coxfuture/One-Handed-Keyboard/Model/readme.md

## Heat-set insert and fastener installation guide

#### Large keyboard

> The left-hand large keyboard is used as the example here.

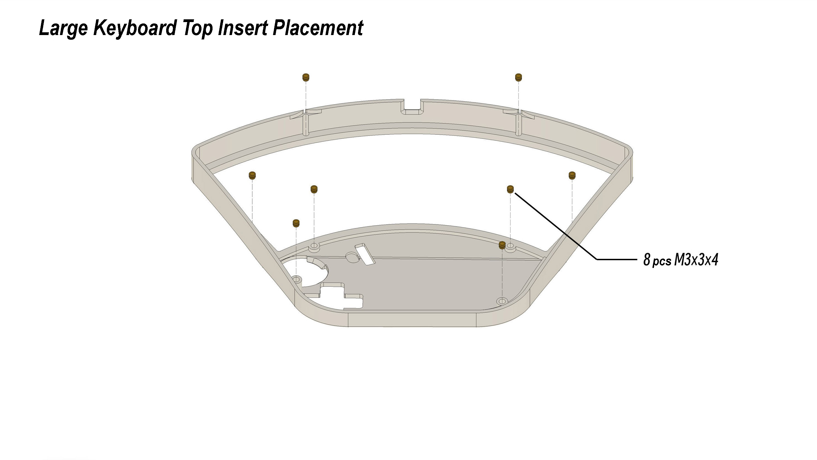
[picture p5: Docs/Image/left-large-keyboard-top-case-insert-guide.jpg]
Left-hand large keyboard: heat-set insert installation in the top case


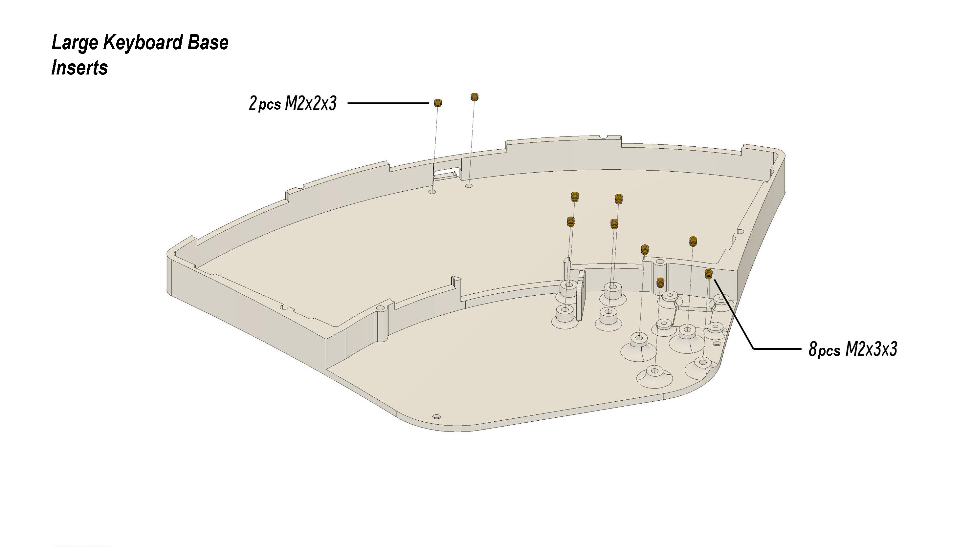
[picture p6: Docs/Image/left-large-keyboard-base-insert-guide.jpg]
Left-hand large keyboard: heat-set insert installation in the base


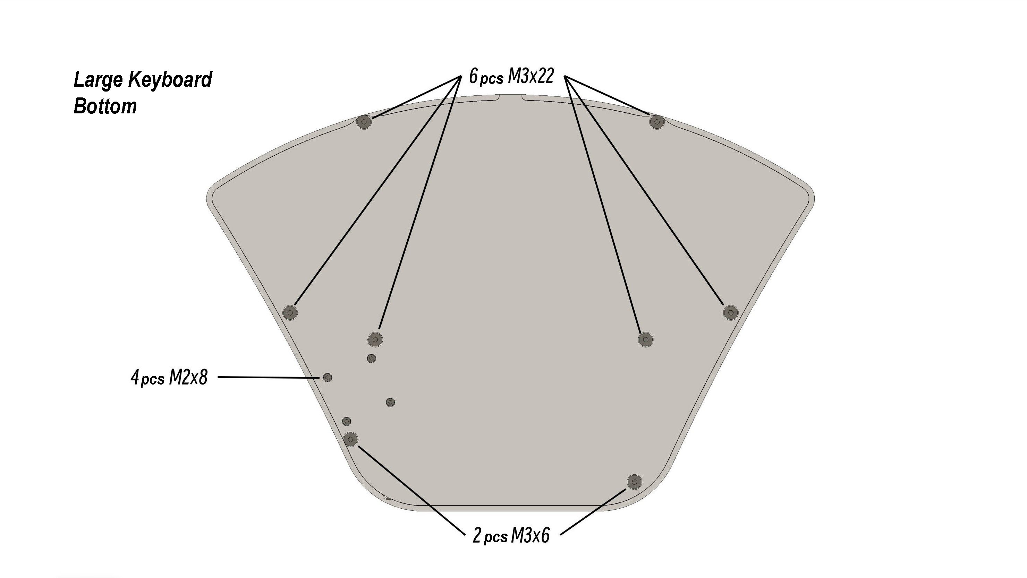
[picture p7: Docs/Image/left-large-keyboard-bottom-screw-guide.jpg]
Left-hand large keyboard: bottom screw installation


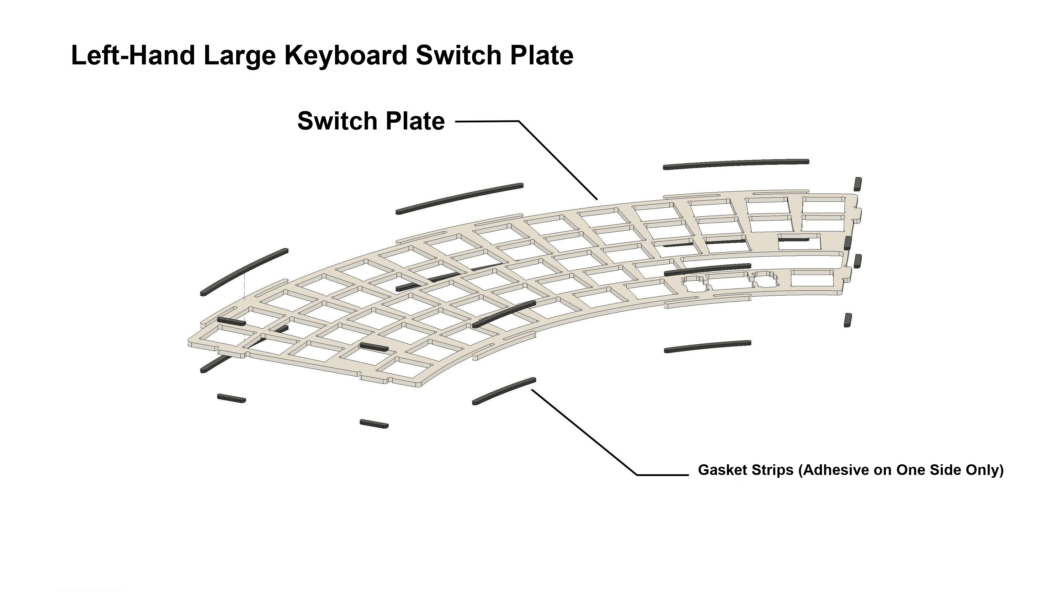
[picture p8: Docs/Image/left-large-keyboard-gasket-strip-guide.jpg]
Left-hand large keyboard: gasket strip installation


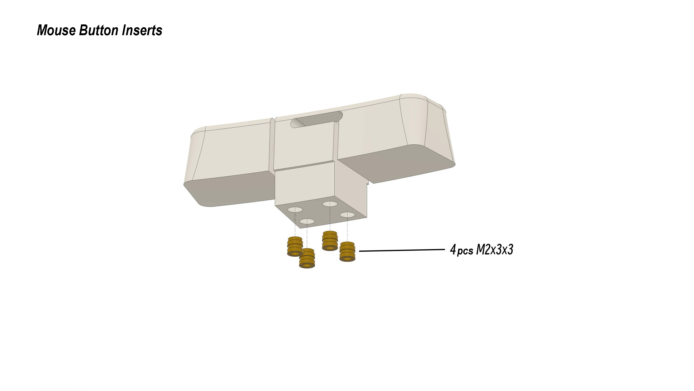
[picture p9: Docs/Image/large-keyboard-mouse-button-insert-guide.jpg]
Large keyboard: heat-set insert installation for the mouse buttons


#### Small keyboard

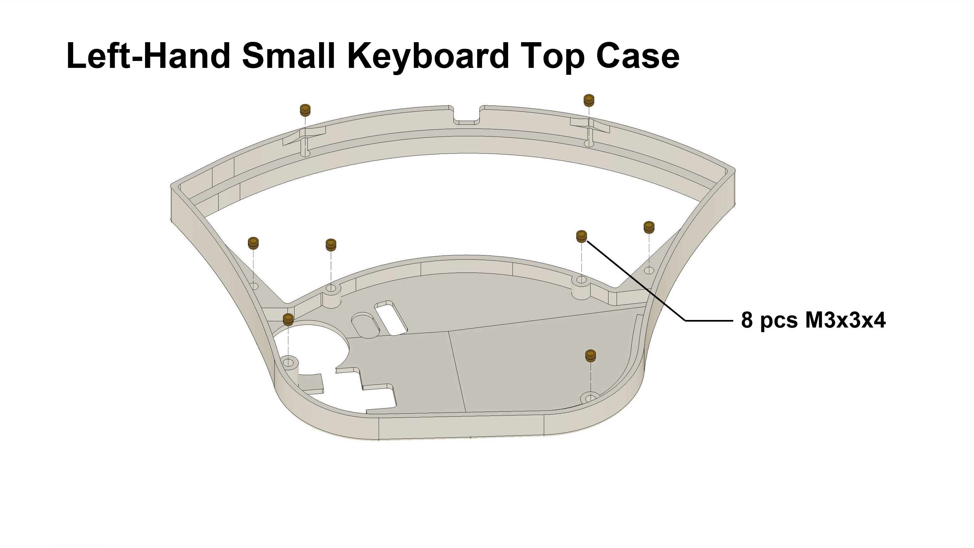
[picture p10: Docs/Image/left-small-keyboard-top-case-insert-guide.jpg]
Left-hand small keyboard: heat-set insert installation in the top case


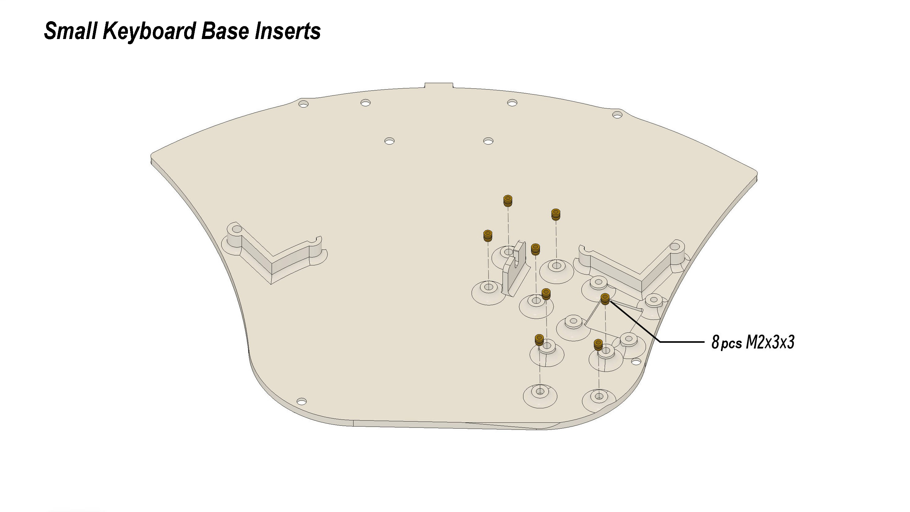
[picture p11: Docs/Image/left-small-keyboard-base-insert-guide.jpg]
Left-hand small keyboard: heat-set insert installation in the base


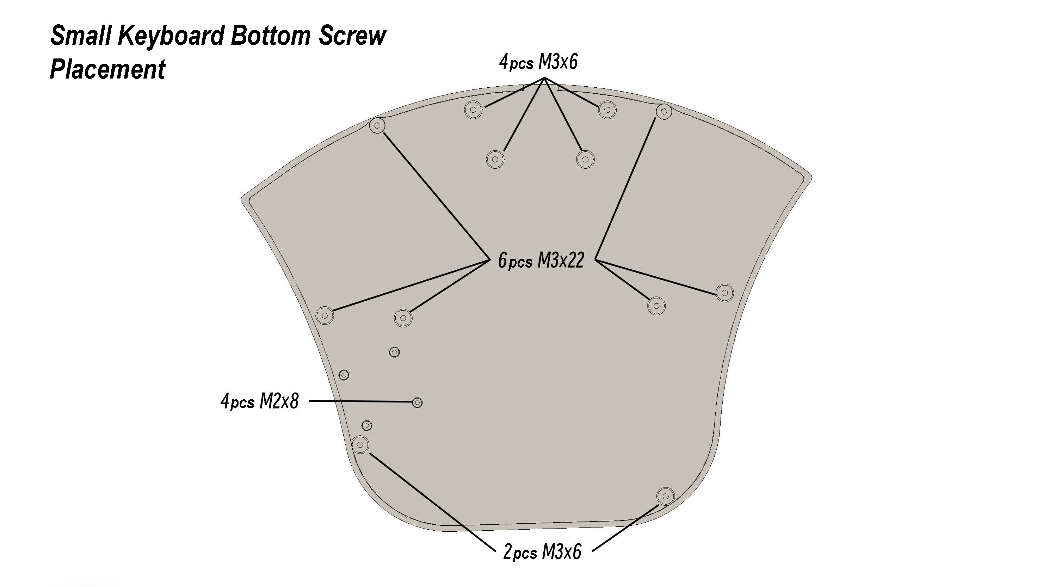
[picture p12: Docs/Image/left-small-keyboard-bottom-screw-guide.jpg]
Left-hand small keyboard: bottom screw installation


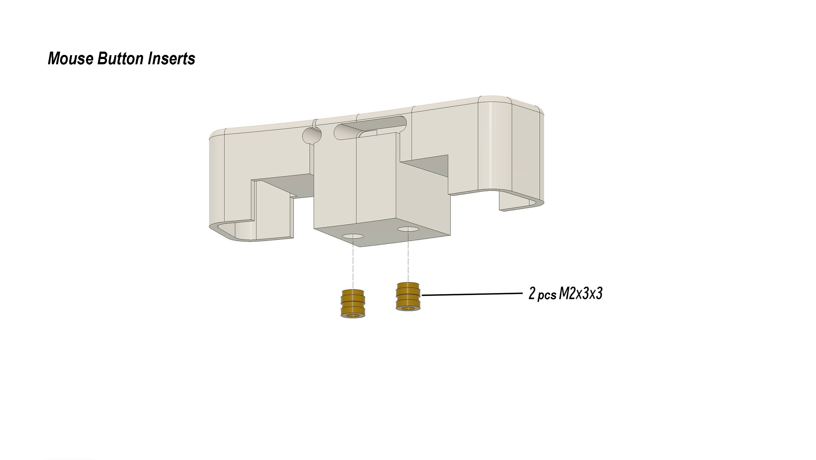
[picture p13: Docs/Image/small-keyboard-mouse-button-insert-guide.jpg]
Small keyboard: heat-set insert installation for the mouse buttons


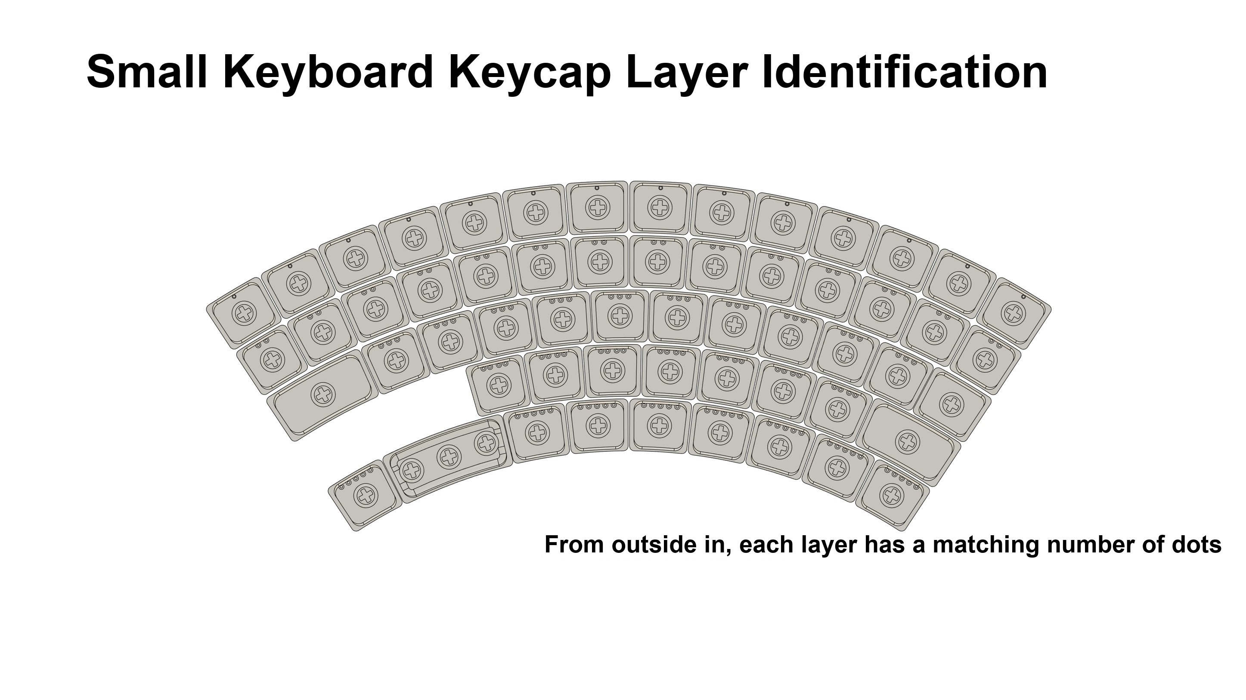
[picture p14: Docs/Image/small-keyboard-keycap-layer-identification.jpg]
Small keyboard: identifying the keycap layers


> The large keyboard's keycaps are identified the same way.

#### Other

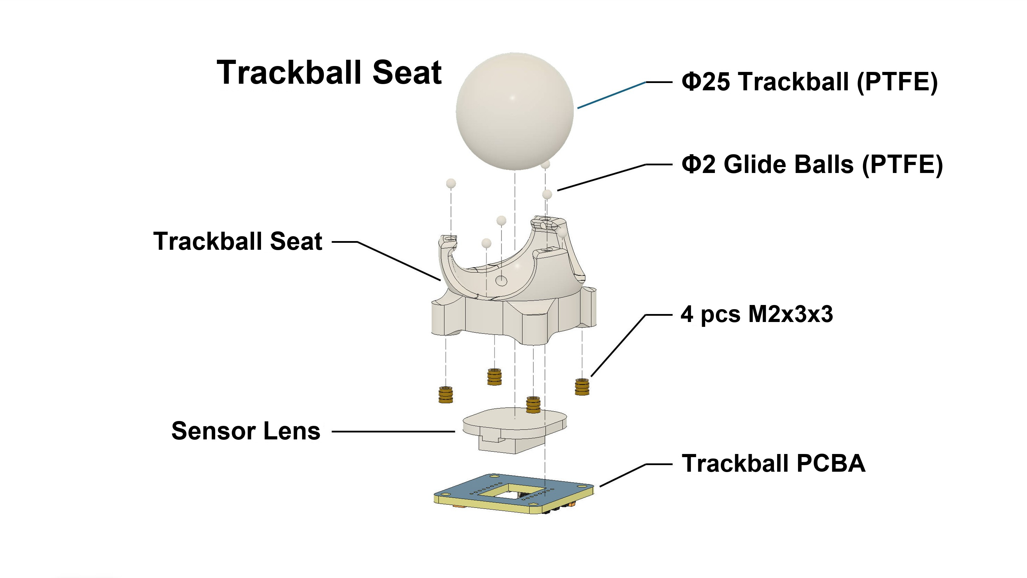
[picture p15: Docs/Image/trackball-installation-guide.jpg]
Trackball installation guide
