coxfuture/One-Handed-Keyboard/Firmware/One-Handed_Keyboard_ML/readme.md

# One-Handed_Keyboard_ML

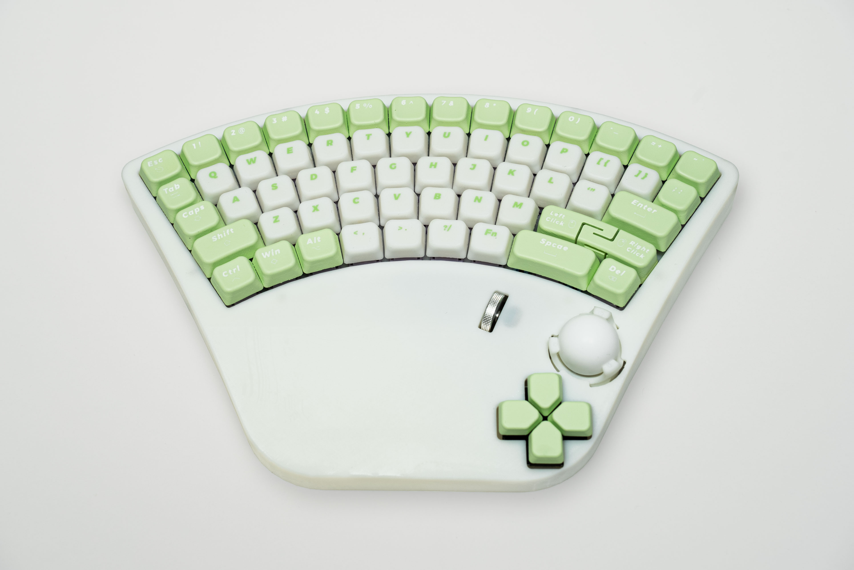
[picture p16: Docs/Image/left-large-keyboard-front.jpg]
Left-hand large keyboard, front


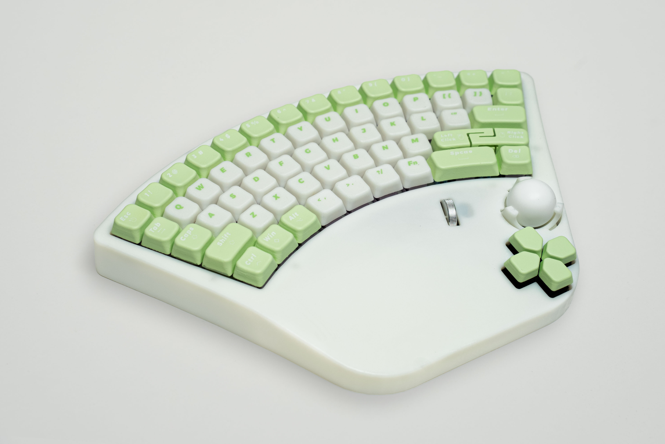
[picture p17: Docs/Image/left-large-keyboard-left-side.jpg]
Left-hand large keyboard, side


---

Powered by [QMK](https://docs.qmk.fm/)
