coxfuture/One-Handed-Keyboard/Firmware/One-Handed_Keyboard_MR/readme.md

# One-Handed_Keyboard_MR

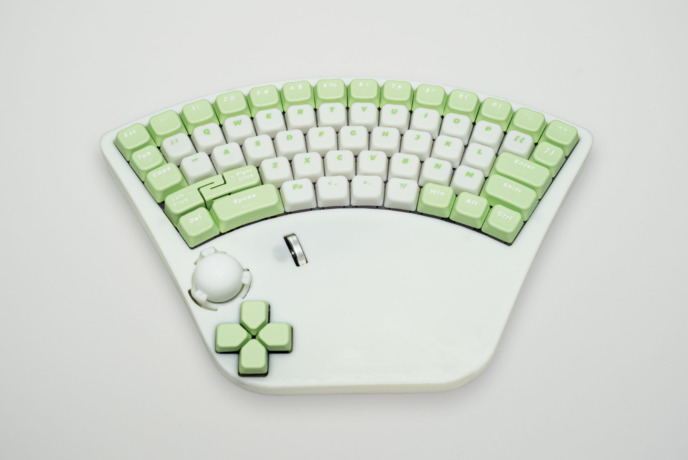
[picture p18: Docs/Image/right-large-keyboard-front.jpg]
Right-hand large keyboard, front


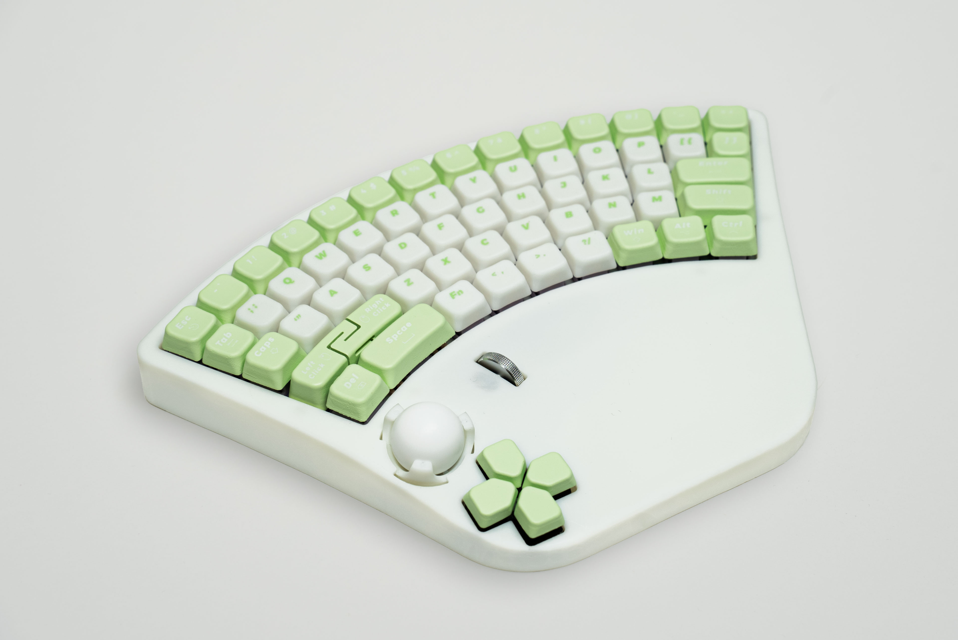
[picture p19: Docs/Image/right-large-keyboard-left-side.jpg]
Right-hand large keyboard, side


---

Powered by [QMK](https://docs.qmk.fm/)
