coxfuture/One-Handed-Keyboard/Firmware/One-Handed_Keyboard_SL/readme.md

# One-Handed_Keyboard_SL

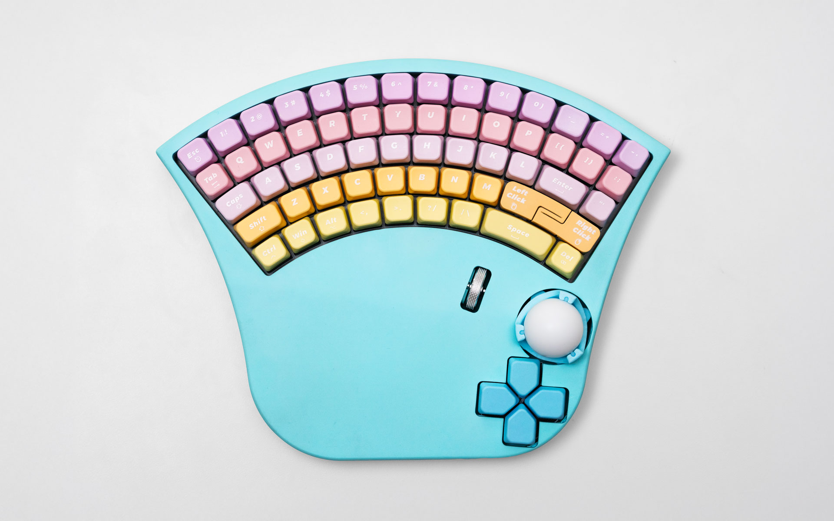
[picture p20: Docs/Image/left-small-keyboard-front.jpg]
Left-hand small keyboard, front


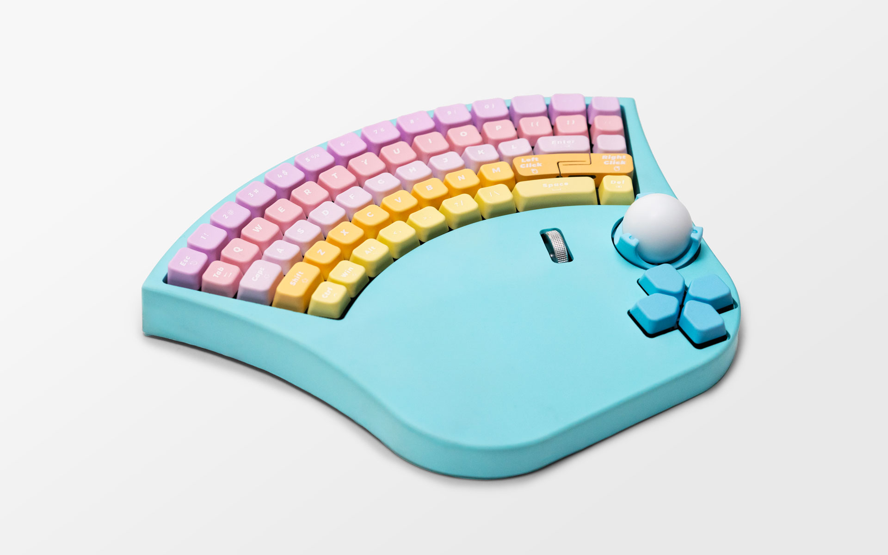
[picture p21: Docs/Image/left-small-keyboard-left-side.jpg]
Left-hand small keyboard, side


---

Powered by [QMK](https://docs.qmk.fm/)
