coxfuture/One-Handed-Keyboard/Docs/Image/right-large-keyboard-right-side.jpg

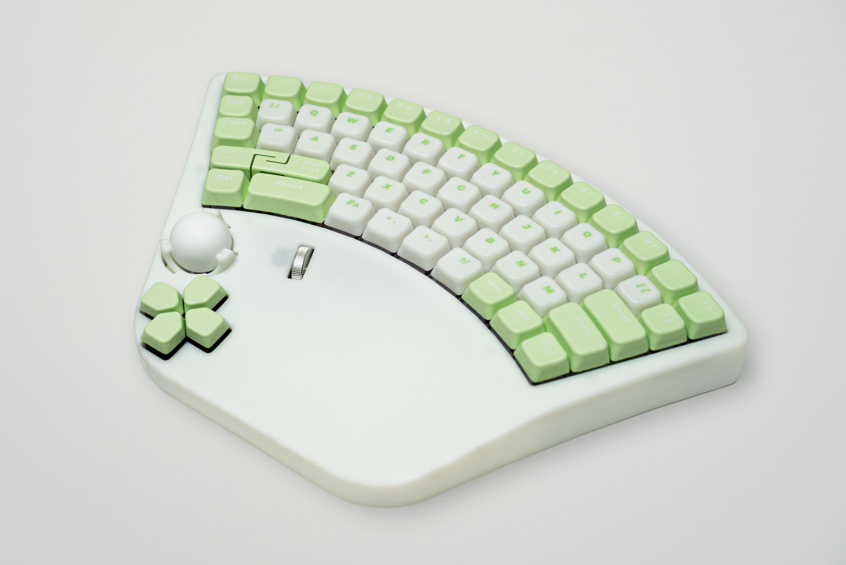
Docs/Image/right-large-keyboard-right-side.jpg
