coxfuture/One-Handed-Keyboard/Model/One-Handed_Keyboard_ML/top-case_left.STL

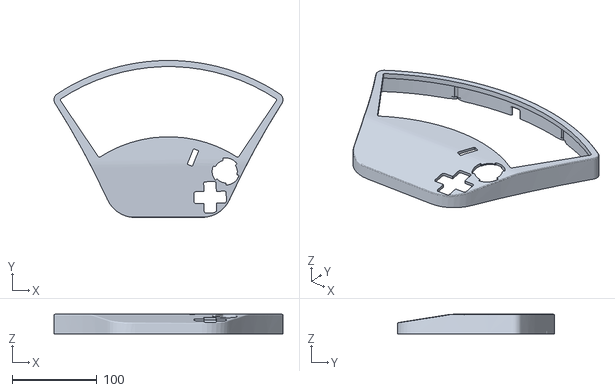
[picture p23: CAD file, 2026-11-01]
Model/One-Handed_Keyboard_ML/top-case_left.STL
269.8 x 185.0 x 23.0
