coxfuture/One-Handed-Keyboard/Model/One-Handed_Keyboard_MR/arrow-key-keycaps.STL

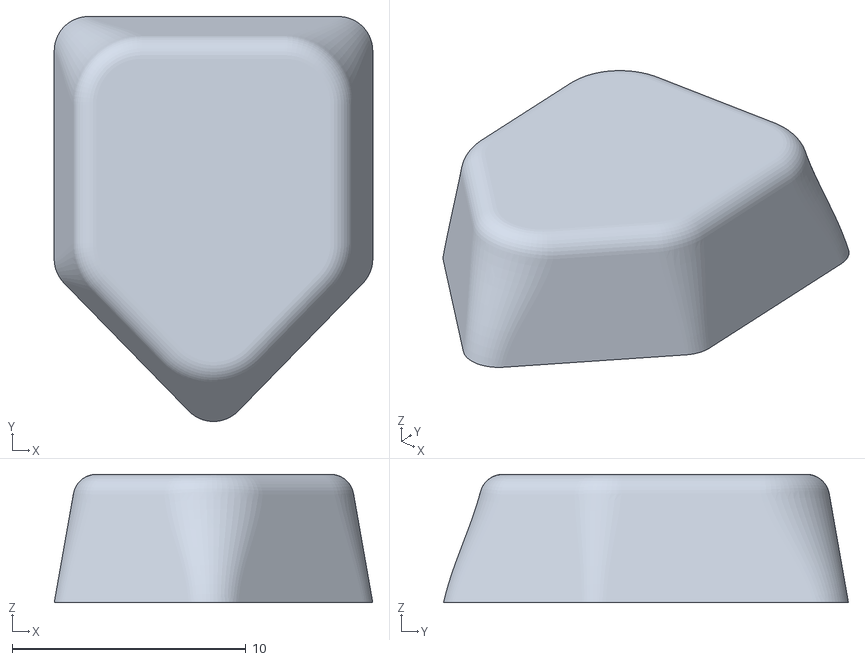
[picture p24: CAD file, 2026-11-01]
Model/One-Handed_Keyboard_MR/arrow-key-keycaps.STL
13.6 x 17.3 x 5.50
