coxfuture/One-Handed-Keyboard/Model/One-Handed_Keyboard_SL/trackball-seat.STL

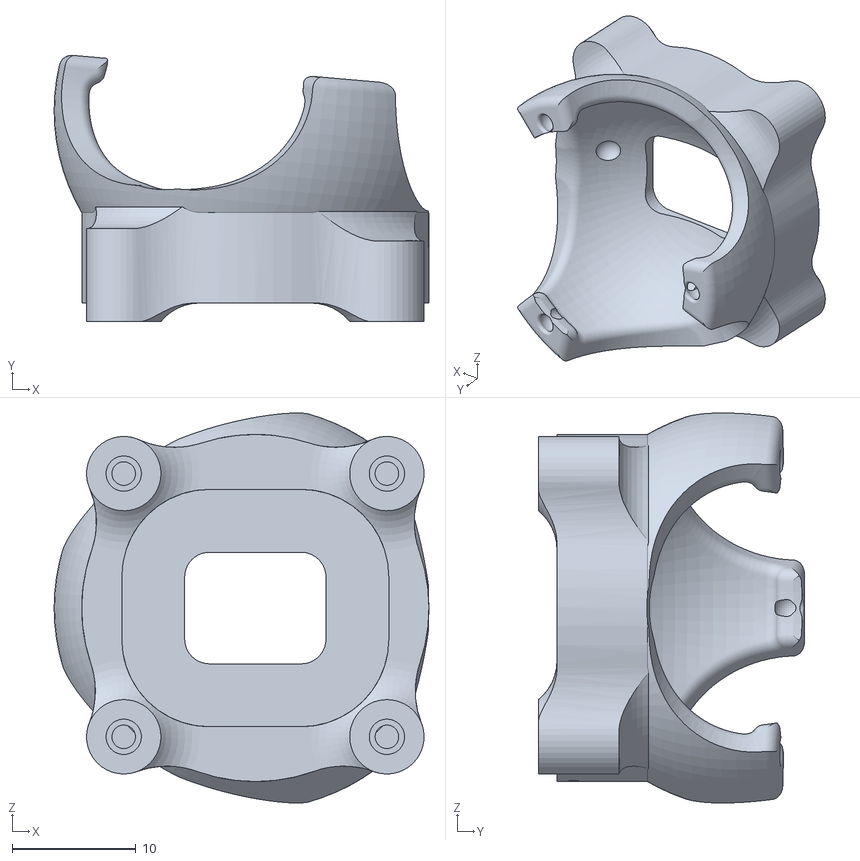
[picture p25: CAD file, 2026-11-01]
Model/One-Handed_Keyboard_SL/trackball-seat.STL
30.2 x 21.5 x 31.5
