coxfuture/One-Handed-Keyboard/Model/One-Handed_Keyboard_ML/plate-gasket-strips-top-bottom.DXF

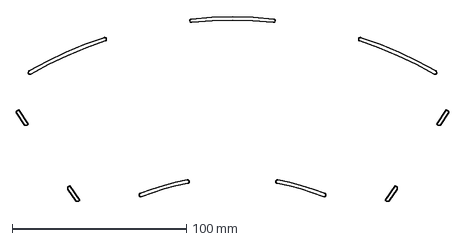
[picture p26: CAD file, 2026-11-01]
Model/One-Handed_Keyboard_ML/plate-gasket-strips-top-bottom.DXF
248.6 x 106.5 mm
