coxfuture/One-Handed-Keyboard/Model/One-Handed_Keyboard_MR/switch-seat-foam_right.DXF

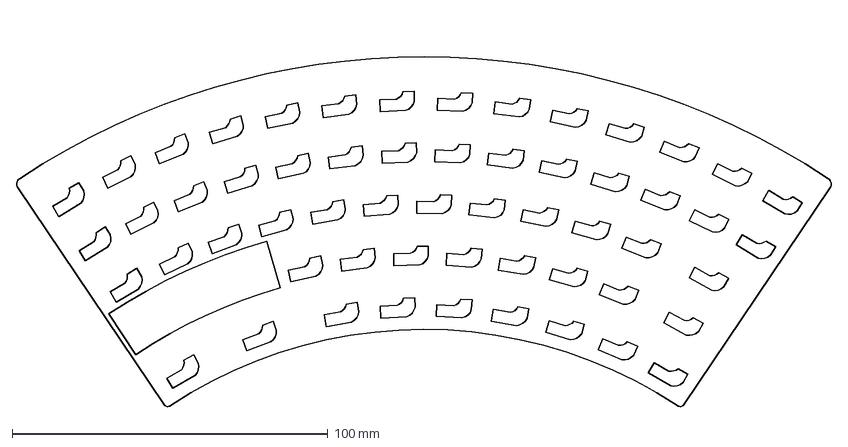
[picture p27: CAD file, 2026-11-01]
Model/One-Handed_Keyboard_MR/switch-seat-foam_right.DXF
258.0 x 123.6 mm
