coxfuture/One-Handed-Keyboard/Model/One-Handed_Keyboard_SL/top-case.STL

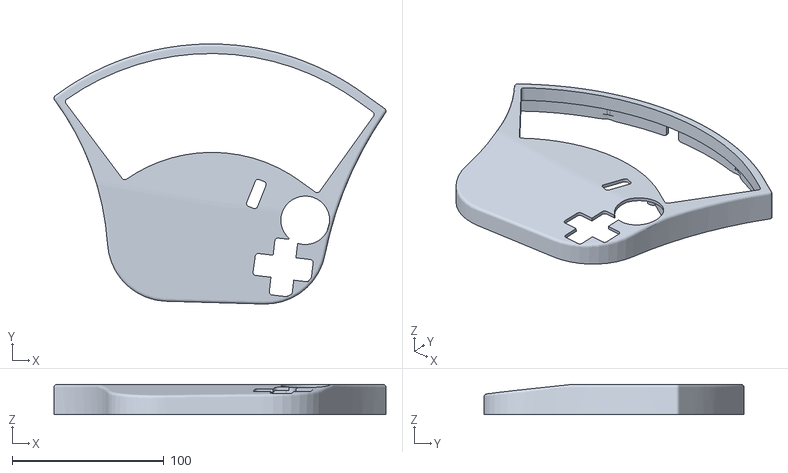
[picture p28: CAD file, 2026-11-01]
Model/One-Handed_Keyboard_SL/top-case.STL
218.6 x 171.2 x 20.0
