coxfuture/One-Handed-Keyboard/Model/One-Handed_Keyboard_ML/mouse-buttons-left-right.STL

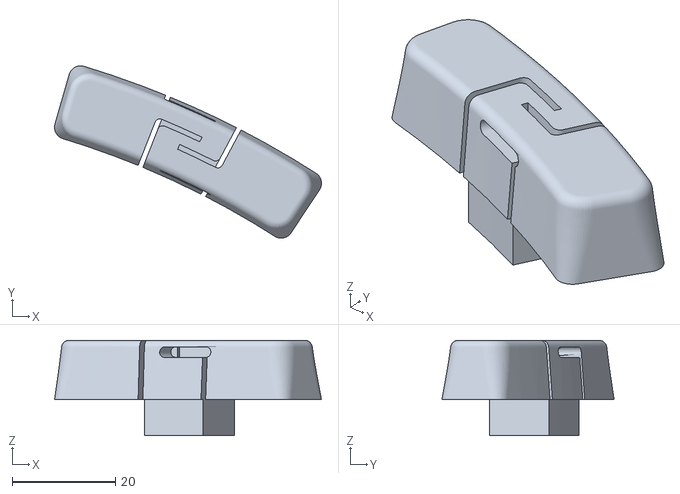
[picture p29: CAD file, 2026-11-01]
Model/One-Handed_Keyboard_ML/mouse-buttons-left-right.STL
51.8 x 33.4 x 18.5
