coxfuture/One-Handed-Keyboard/Model/One-Handed_Keyboard_MR/base_right.STL

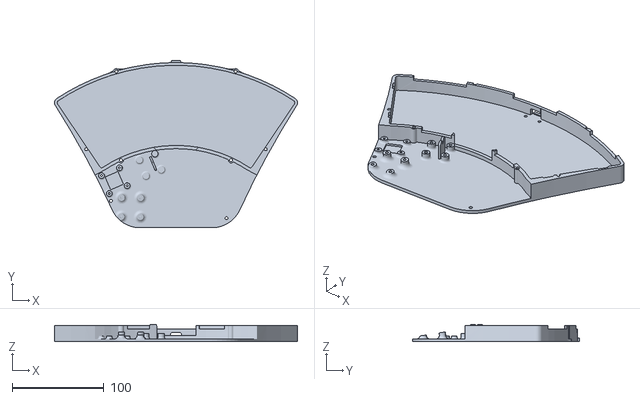
[picture p30: CAD file, 2026-11-01]
Model/One-Handed_Keyboard_MR/base_right.STL
264.7 x 182.5 x 19.0
