coxfuture/One-Handed-Keyboard/Model/One-Handed_Keyboard_SL/base.STL

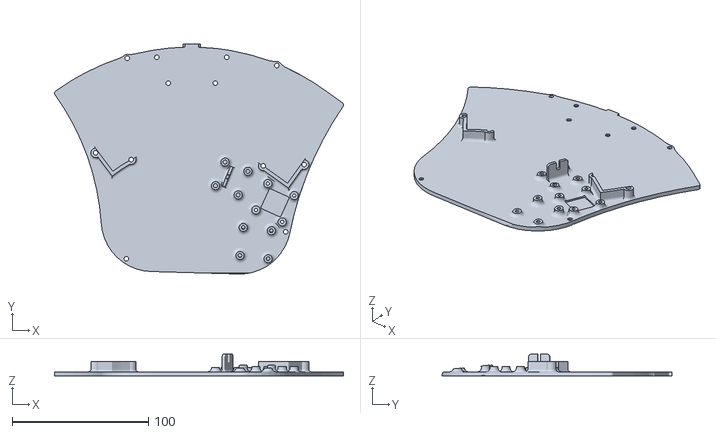
[picture p31: CAD file, 2026-11-01]
Model/One-Handed_Keyboard_SL/base.STL
212.2 x 168.9 x 16.0
