coxfuture/One-Handed-Keyboard/Model/One-Handed_Keyboard_ML/switch-plate_left.DXF

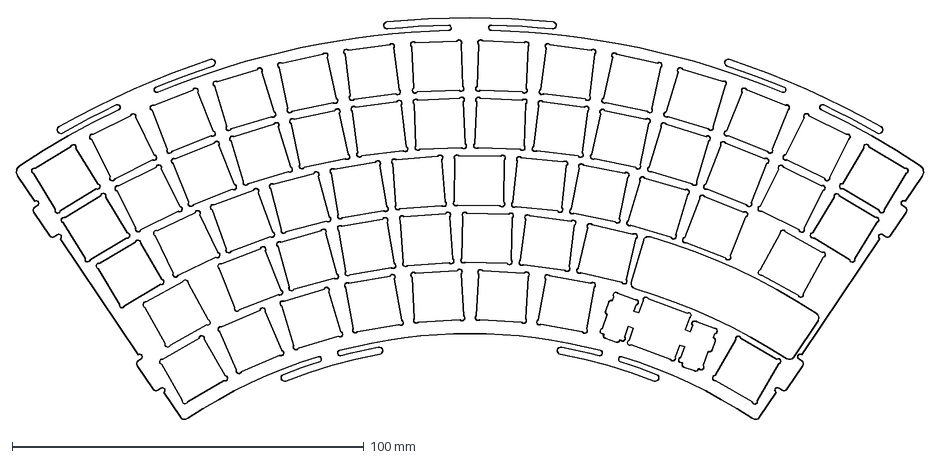
[picture p32: CAD file, 2026-11-01]
Model/One-Handed_Keyboard_ML/switch-plate_left.DXF
258.0 x 114.6 mm
