coxfuture/One-Handed-Keyboard/Model/One-Handed_Keyboard_SL/silicone-pad.DXF

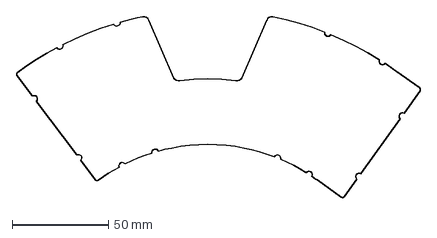
[picture p33: CAD file, 2026-11-01]
Model/One-Handed_Keyboard_SL/silicone-pad.DXF
210.0 x 94.5 mm
