coxfuture/One-Handed-Keyboard/Model/One-Handed_Keyboard_MR/switch-plate_right.DXF

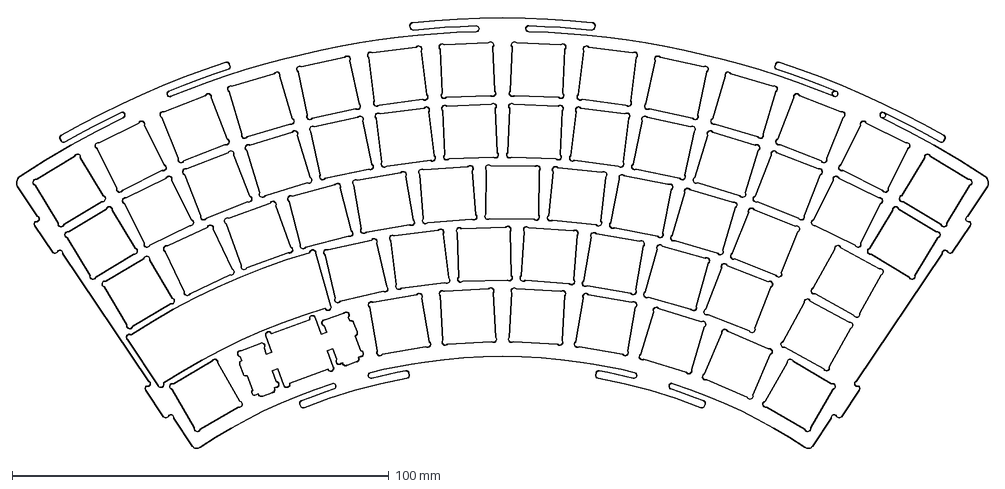
[picture p34: CAD file, 2026-11-01]
Model/One-Handed_Keyboard_MR/switch-plate_right.DXF
258.0 x 114.6 mm
