coxfuture/One-Handed-Keyboard/Model/One-Handed_Keyboard_SL/keycaps.STL

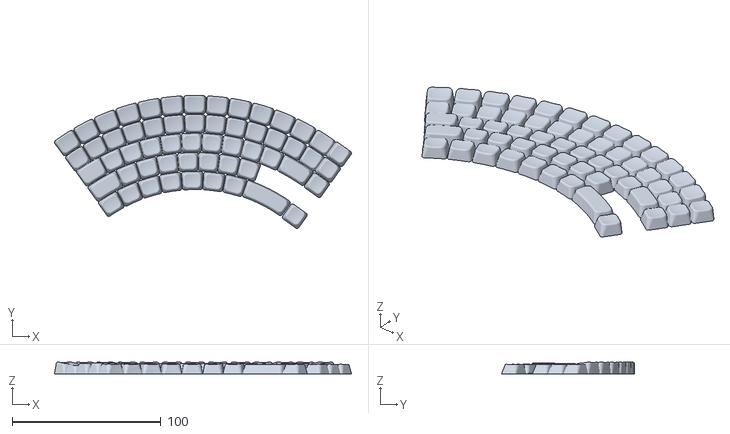
[picture p35: CAD file, 2026-11-01]
Model/One-Handed_Keyboard_SL/keycaps.STL
199.9 x 89.5 x 7.96
