coxfuture/One-Handed-Keyboard/Model/One-Handed_Keyboard_MR/gasket-sandwich-foam_right.DXF

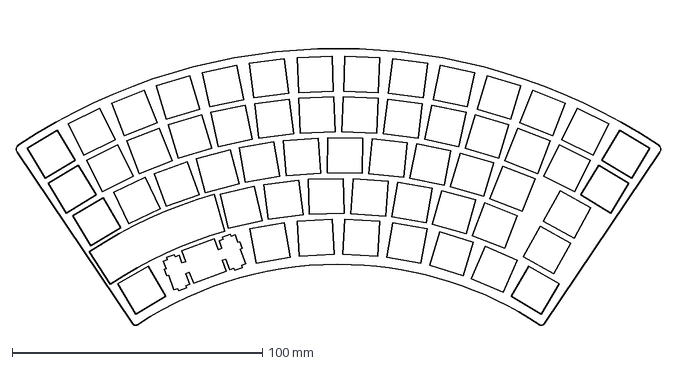
[picture p36: CAD file, 2026-11-01]
Model/One-Handed_Keyboard_MR/gasket-sandwich-foam_right.DXF
258.0 x 123.7 mm
