coxfuture/One-Handed-Keyboard/Model/One-Handed_Keyboard_ML/gasket-sandwich-foam_left.DXF

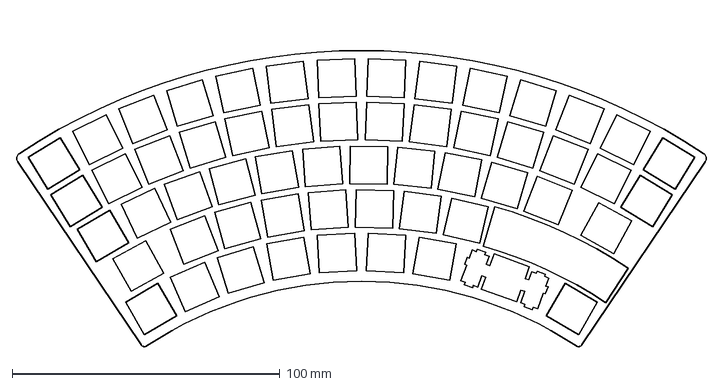
[picture p37: CAD file, 2026-11-01]
Model/One-Handed_Keyboard_ML/gasket-sandwich-foam_left.DXF
258.0 x 123.6 mm
