coxfuture/One-Handed-Keyboard/Model/One-Handed_Keyboard_MR/case-bottom-foam.DXF

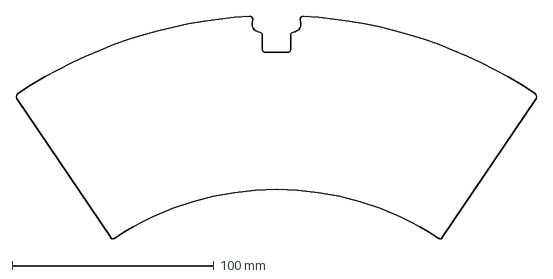
[picture p38: CAD file, 2026-11-01]
Model/One-Handed_Keyboard_MR/case-bottom-foam.DXF
258.0 x 110.4 mm
