coxfuture/One-Handed-Keyboard/Model/One-Handed_Keyboard_SL/mouse-buttons-left-right.STL

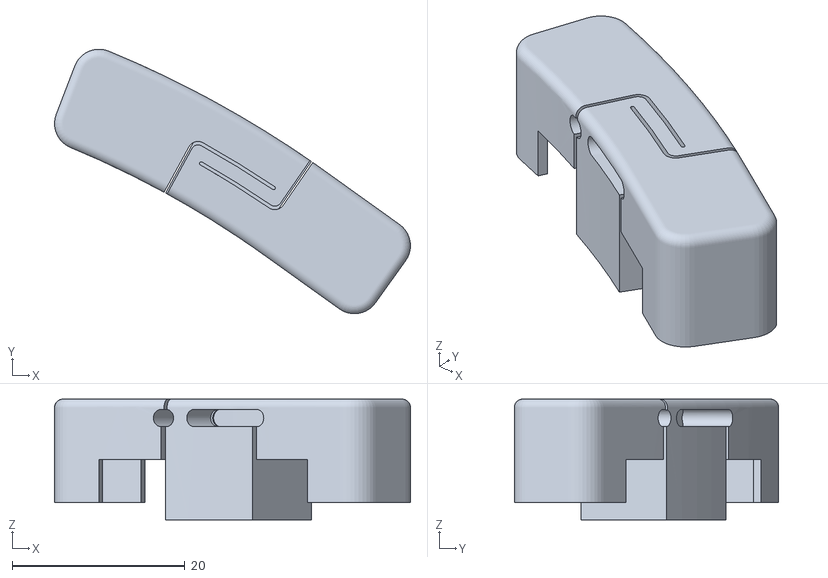
[picture p39: CAD file, 2026-11-01]
Model/One-Handed_Keyboard_SL/mouse-buttons-left-right.STL
41.2 x 30.6 x 14.0
