coxfuture/One-Handed-Keyboard/Model/One-Handed_Keyboard_ML/keycaps_left.STL

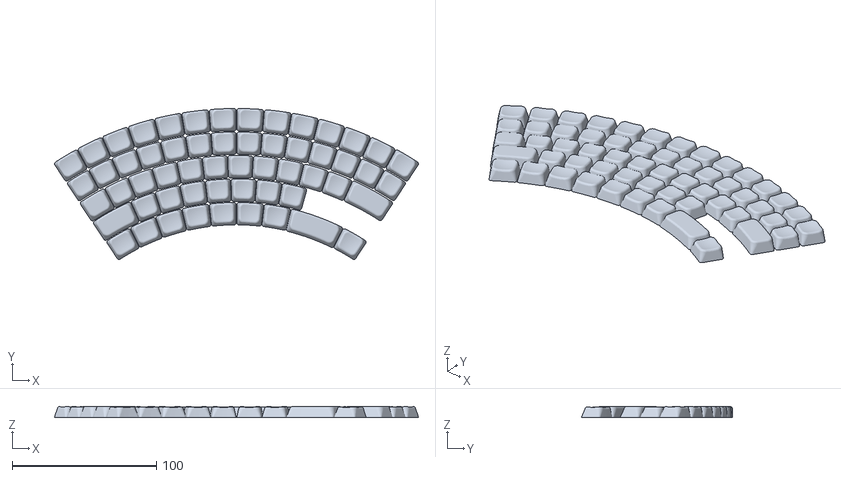
[picture p40: CAD file, 2026-11-01]
Model/One-Handed_Keyboard_ML/keycaps_left.STL
252.8 x 104.9 x 7.60
