coxfuture/One-Handed-Keyboard/Model/One-Handed_Keyboard_MR/top-case_right.STL

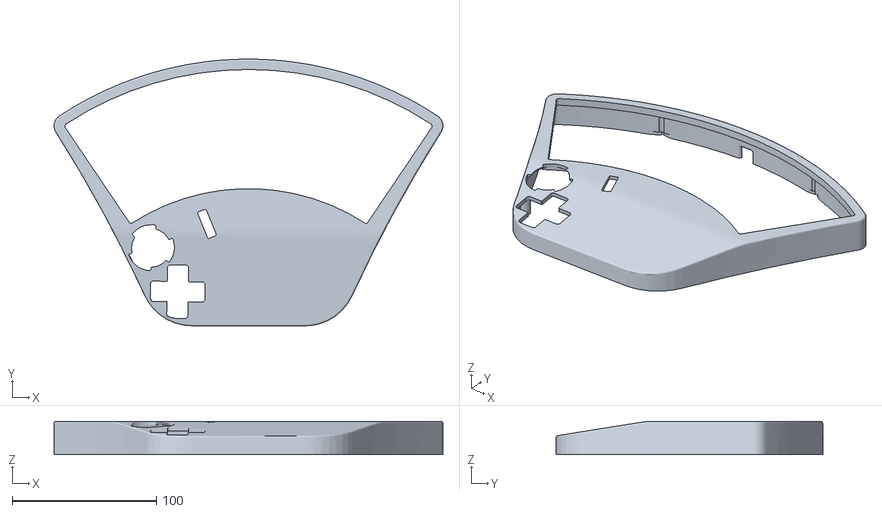
[picture p41: CAD file, 2026-11-01]
Model/One-Handed_Keyboard_MR/top-case_right.STL
269.8 x 185.0 x 23.0
