coxfuture/One-Handed-Keyboard/Model/One-Handed_Keyboard_ML/switch-seat-foam_left.DXF

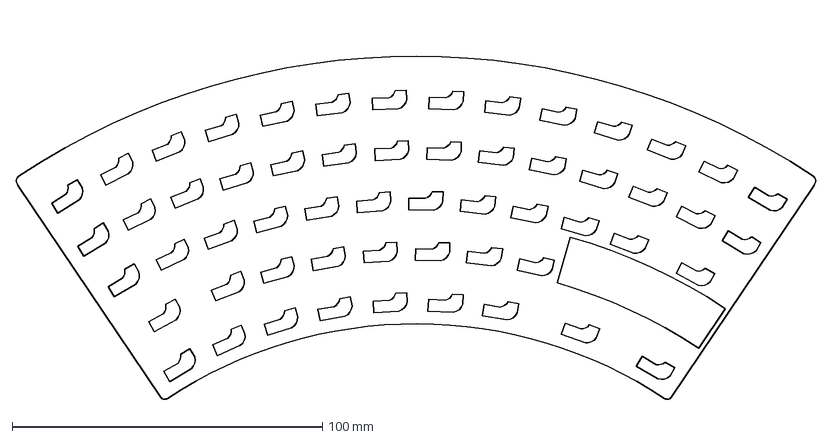
[picture p42: CAD file, 2026-11-01]
Model/One-Handed_Keyboard_ML/switch-seat-foam_left.DXF
258.0 x 123.6 mm
