coxfuture/One-Handed-Keyboard/(list of files, cad)

Other CAD files:
Model/One-Handed_Keyboard_ML/base_left.STL
Model/One-Handed_Keyboard_MR/keycaps_right.STL
