coxfuture/One-Handed-Keyboard/(commit log)

2026-11-01 docs: rename assets to English filenames and update links
    English-speaking builders cloning this repo have to type Chinese
    filenames to open a model or a diagram, and non-ASCII paths are where
    archive and shell tooling tends to break. Renaming the images and model
    files makes every asset referenceable, and it is also what lets the
    READMEs stop containing Chinese: the model assembly guide and the
    firmware image captions are translated here too.
    Every link that pointed at a renamed file is updated in this same
    commit, so the repository stays link-consistent at every step of the
    translation. Image contents are untouched here; the burned-in label text
    is replaced in a follow-up commit so the re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
    [arrow-key-keycaps.STL, base.STL, base_left.STL, base_right.STL, case-bottom-foam.DXF, gasket-sandwich-foam_left.DXF, gasket-sandwich-foam_right.DXF, keycaps.STL]
2026-11-01 docs: replace burned-in Chinese labels with English in diagrams
    The exploded views and the assembly diagrams are what a first-time
    builder actually follows, so an English README describing pictures the
    reader cannot still read leaves the build guide half translated. The
    English text is drawn over the Chinese at the same cap height and pinned
    to the same edge of the leader line, so the diagrams keep their layout.
    The originals stay in the history of `main`, and nothing outside the old
    text was redrawn.
    Six diagrams are covered here — both exploded views, the trackball seat,
    the gasket strips, the small keyboard's top-case inserts and the keycap
    layer identification. The remaining diagrams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
2026-11-01 docs: replace Chinese labels with English in remaining diagrams
    Completes the English translation of all diagram assets. The labels in these seven assembly guides were hand-replaced to match the terminology used in the already-translated diagrams and the readme alt text, so the whole Docs/Image set now reads consistently. Screw counts and leader lines are untouched: the M3x22 label on the small keyboard bottom still points at five holes despite claiming six, which is how the upstream original draws it.
